alf239/speccy/docs/img/typed.png

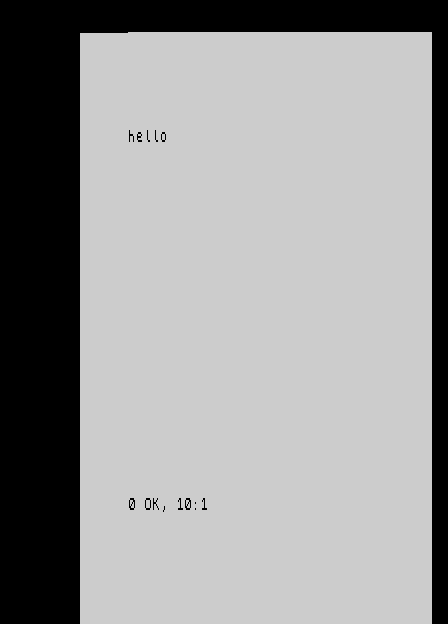
docs/img/typed.png
