alf239/speccy/(commit log)

2026-07-27 Stage 0: ZX Spectrum video generator + Verilator harness
    Raster timing (448x312 @ 7 MHz), screen address generation, attribute
    decode with BRIGHT/FLASH, and border colour from a register. Verified in
    simulation: 139776 pixels per frame, correct cell boundaries and colours.
    No CPU yet. Screen memory is loaded through the RAM's CPU-side port, which
    is deliberately the same port a Z80 will use later -- video time-multiplexes
    its own port for bitmap and attribute, so the two never collide.
    Also includes the design docs leading to the phase 1 target: a 48K machine
    with divMMC, fitting entirely in block RAM.
    [main.cpp, speccy_video_top.v, video.v, video_timing.v, vram.v]
2026-07-27 Add README
    Project overview, quick start, layout, and roadmap, with pointers into the
    design docs. Includes the stage 0 raster dump as evidence it works.
2026-07-27 Stage 1a: scandoubler, 15.625 -> 31.25 kHz
    Ping-pong line buffers reading each input line back at twice the rate.
    No rate matching needed: one input line is exactly 896 cycles of the 14 MHz
    clock, which is two output lines of 448.
    Pipeline is now indexed colour end to end (video -> scandoubler -> palette),
    so the line buffer carries 4 bits per pixel instead of 12, and there is one
    obvious place to hang a programmable palette later.
    The harness now checks rather than just draws: pixel counts on both rasters,
    output line pairs byte-identical, and the doubled line set matching the input
    line set. Exits non-zero on failure.
    Two bugs found and fixed by those checks:
    - vsync/vblank needed the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
    [main.cpp, palette.v, scandoubler.v, speccy_video_top.v, video.v, video_timing.v]
2026-07-27 Stage 1b/1c: board wrapper, Kempston joystick, memory image export
    The joystick needs no level shifting -- an Atari DE-9 stick is five passive
    switches to ground, so weak pull-ups on the FPGA pins are the whole interface.
    That makes it the one peripheral testable on hardware with no CPU.
    rtl/joystick.v synchroniser, debounce, Kempston 000FUDLR mapping
    rtl/de10_lite_top.v board wrapper: PLL, VGA, SW->border, joystick->LEDs/HEX
    sim/joystick_tb.cpp every direction and combination checked individually
    The bit mapping between a DE-9 connector and a Kempston port byte is exactly
    the thing that stays silently wrong until a game walks left when you push
    right, so it gets its own testben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
    [de10_lite_top.v, joystick.v, joystick_tb.cpp, main.cpp, speccy_video_top.v, vram.v]
2026-07-27 The machine around the CPU socket: memory map, ULA ports, INT
    Everything a Z80 plugs into, verified before choosing a CPU core. If the
    machine later misbehaves with a real Z80 in the socket, the fault is in the
    CPU rather than here.
    rtl/ram.v single-port RAM; a ROM is this with we tied low
    rtl/keyboard.v 48K matrix, 8 half-rows selected by A8..A15
    rtl/speccy.v memory map, port 0xFE, Kempston, 50 Hz interrupt, video
    sim/bus_tb.cpp the harness pretends to be the Z80
    Covered: ROM ignoring writes, banks not aliasing, any-even-port ULA decode,
    keyboard rows OR-ing when several are selected at once (which is how the ROM
    scans for any key), EAR on bit 6, Kempston bit mapping, a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
2026-07-27 Stage 3b: TV80 in the socket, executing code
    Vendored TV80 (github.com/hutch31/tv80 @ 66a131c, MIT, headers intact) with
    two local changes in tv80s.v, both marked and documented in rtl/tv80/README:
    1. cen exposed as a port -- tv80_core already implements the clock enable,
    the wrapper just tied it to 1. This runs the core at 3.5 MHz off the
    14 MHz machine clock.
    2. The wrapper's bus-signal block gated with the same cen. Ungated, it
    deasserted mreq_n/rd_n partway through a multi-clock T2, so every
    opcode fetch sampled the idle bus (0xFF = RST 38h) and the CPU
    livelocked pushing its own PC. The smoke test caught it on first run.
    speccy48.v is the complete machine.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
2026-07-27 Hardware pack: complete Quartus project, full-machine board top, boot test
    The Windows-box session is now: clone, convert ROM, open speccy.qpf, compile,
    program. No IP wizard, no pin import.
    quartus/speccy.qsf 121 pin assignments, cross-checked against three
    independent DE10-Lite projects (hildebrandmw/
    de10lite-hdl, MIPSfpga/schoolMIPS, yuri-panchul/
    basics-graphics-music) -- zero disagreements
    rtl/pll.v altpll instantiated by hand: 50 x 7/25 = 14 MHz
    rtl/de10_lite_speccy48.v the full machine on the board; boots rom48.hex
    to (c) 1982 with no keyboard attached
    tools/bin2hex.py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
2026-07-27 Fix make boot frame count; the machine boots the real 48K ROM
    make boot captured frame 7 instead of frame 174: the global FRAMES ?= 8
    default (meant for the video target) always satisfied boot's
    $(if $(FRAMES),...,175) fallback, so the "black screen" bug report was a
    photograph of the RAM test in progress -- border already white, attributes
    not yet written. The machine itself was booting correctly the whole time,
    confirmed by PC-histogram traces: RAM test done at ~25M cycles (1.8 s,
    matching real hardware), (c) 1982 rendered, then WAIT-KEY polling KEY-INPUT.
    Both targets now use $(or ...) locally and no global default exists.
    README now leads with the boot screenshot -- produced entirely b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
2026-07-27 Mark the hardware milestone: it boots on the real board
    (c) 1982 Sinclair Research Ltd on a VGA monitor, first-try bring-up.
    PLL parameters, all 121 pin assignments, and 50.08 Hz over VGA worked
    without modification.
2026-07-27 Bring-up postscript: hardware works; beeper output circuit
2026-07-27 Stage 3e: PS/2 keyboard, verified by typing into the real ROM
    rtl/ps2_rx.v: receive-only PS/2 receiver -- 11-bit frames, parity checked,
    watchdog resync. rtl/ps2_keyboard.v: scancode set 2 to the 40-key matrix,
    E0/F0 prefix tracking, chords for Backspace (CAPS+0), arrows (CAPS+5..8)
    and basic punctuation (SYM chords), E0 12 fake shifts ignored.
    18-case unit testbench (make ps2test), and the boot harness gained a
    typist: --type drives real scancode traffic into the PS/2 pins while the
    machine runs. Against the actual 48K ROM it has typed 10 P"hello" and R:
    program entered, executed, "hello" printed, 0 OK, 10:1. Screenshot in
    docs/img/typed.png.
    Two ROM behaviours the typist had to learn, bo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
2026-07-28 Phase 2 note: AY-vs-YM DAC curve on a switch, live-selectable
2026-07-28 Verified GPIO header pin table from the manual; wiring crib by physical pin
2026-07-28 Move every peripheral to the odd header column
    One physical row wires the whole machine: joystick on pins 1-3-5-7-9
    (GPIO[0,2,4,6,8]), keyboard 5V conveniently next at pin 11, PS/2 on 31/33
    (GPIO[26,28]), beeper on 39 (GPIO[34]). A single ground wire crosses to the
    even side. The Verilog cost is one commented concatenation; the breadboard
    gain is not having to count in two dimensions.
    Both board tops, qsf pull-ups, and the bring-up doc tables updated to match.
2026-07-28 Cobbler translation table; fix the ground row
    The GND label at the top of J2 is Pi pin 6 = DE10-Lite GPIO[5], a live
    FPGA I/O -- grounding peripherals there gives them no return path at all.
    Real grounds are J2 row 6 (labelled P18) and row 15 (labelled GND, truthful
    only by coincidence). Caught by Alexey cross-checking the Terasic manual.
2026-07-28 Pigtail ground wire is black, not blue (ambiguous 'B' in bench notes)
2026-07-28 PS/2 diagnostics on the 7-seg displays; debugging notes
    HEX3:2 = last scancode (a live keyboard shows AA from its power-on
    self-test before any key is pressed), HEX4 = raw clock-edge activity,
    HEX5 = frame-error count. Turns the board into its own protocol tester
    for the next keyboard: the stray NEXT keyword during contact-wiggling
    already proved receiver -> mapper -> matrix -> ROM works on real hardware.
    [de10_lite_speccy48.v]
2026-07-28 The Pi cobbler grounds six of our pins; move fire and beeper off them
    Kempston read 0x10 with no joystick attached: fire (GPIO[8], header pin 9)
    sits in a cobbler hole labelled GND, and the board pours all Pi-ground
    holes (Pi pins 6/9/14/20/25/30/34/39) into one net. DE10-Lite pin 30 is
    real ground, so the whole net is grounded -- five FPGA inputs and the
    beeper output included.
    Fire: GPIO[8] -> GPIO[10] (header pin 13, cobbler hole P27).
    Beeper: GPIO[34] -> GPIO[32] (header pin 37, cobbler hole P26).
    GPIO[8,11,17,22,29,34] documented as grounded-while-cobbler-fitted and
    kept tri-stated. Both board tops, qsf pull-ups and all doc tables updated.
    Diagnosis credit: the HEX Kempston readout ad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
2026-07-29 Stage 3g: .z80 snapshot loader -- boot straight into a game, no keys
    tools/snap2hex.py parses .z80 v1/v2/v3 (48K, compressed or not) and emits
    RAM bank init files plus a generated Z80 bootstrap: ~60 bytes restoring
    every register (alternates via below-stack push/pop, I, R, IM, border),
    ending in JP to the snapshot's PC.
    The machine gained a boot overlay: the stub shadows 0x0000-0x00FF from
    reset (armed by SW[1] on the board), and the first opcode fetch at or
    above 0x0100 -- the stub's own JP -- disarms it forever, restoring the
    real ROM under the running game.
    Verified end to end: a synthetic snapshot regression in make test (85
    checks now), and Saboteur II's actual .z80 boots to its title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
    [boot_tb.cpp, boot_tb_top.v, de10_lite_speccy48.v, speccy.v, speccy48.v, speccy48_tb_top.v]
2026-07-29 Tap-keys J and S on SW[6]/SW[7] (edge-triggered single press)
    key_tap.v: one synchronised rising edge of a slide switch = one ~80 ms
    keypress, then release regardless of switch position; flip down to re-arm.
    The right shape for menu letters, where a held slide switch would read as
    a stuck key. Switch already up at power-on does not fire.
    Full switch map documented: SW[0] free, SW[1] snapshot, SW[5:2] held
    ENTER/SPACE/1/2, SW[7:6] tap J/S, SW[8] reserved AY/YM, SW[9] sync.
    [de10_lite_speccy48.v, key_tap.v]
2026-07-29 Force M9K inference for ram.v -- fixes snapshot-stub synthesis failure
    Quartus implements the 256-byte stub as logic-cell registers (below its
    RAM-inference threshold), and register RAM cannot take an init file on
    MAX 10: error 276013 "MIF is not supported", then 276003 as the register
    fallback explodes. (* ramstyle = "M9K" *) pins every ram.v instance to
    block RAM, which is where they all belonged anyway. Verilator ignores
    the attribute; all 85 checks still green.
    [ram.v]
2026-07-29 Pin MAX 10 internal configuration to SINGLE IMAGE WITH ERAM
    Without memory-initialization in the internal flash configuration mode,
    MAX 10 block RAM cannot carry initial contents: every $readmemh memory
    (ROM, VRAM, upper RAM, snapshot stub) reports 276013 "MIF is not
    supported for the selected family" and synthesis fails at 276003. The
    qsf never pinned this, so it floated on whatever the local Quartus had
    -- the first successful build got a permissive mode by luck, the fresh
    checkout did not. Now explicit.
2026-07-29 Snapshot survives re-reset: shadow RAM + boot copier
    Block RAM init is configuration-time only, so the snapshot boot worked
    exactly once per programming: any later armed reset restored the
    snapshot's registers over whatever RAM held by then -- observed on
    hardware as the old BASIC screen frozen in the resumed PAUSE loop.
    The snapshot now lives twice: main banks (config init, as before) plus a
    never-written shadow pair. An armed reset holds the CPU (~7 ms) while a
    two-phase copier refills all 48K from the shadow, then releases into the
    stub. SW[1]+KEY[0] boots the game every time.
    New regression: boot normally for two frames (RAM scribbled), re-arm and
    reset mid-run, assert the snapshot sti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
    [boot_tb.cpp, speccy.v, speccy48.v]
2026-07-29 Piezo wiring option: direct drive through 47R, not the line divider
2026-07-30 boot_tb: --wav captures the beeper line to audio
    Samples the speaker at 43.75 kHz into 8-bit mono WAV. First use: extracting
    the menu music from the Saboteur II snapshot by running the machine and
    recording it, which beats static analysis of a self-modifying player whose
    tune pointer happened to be frozen at zero.
2026-08-01 Stage 5 design: divMMC + SD fit audit, pin plan, verification plan
2026-08-01 Stage 5 begins: SPI master + behavioural SDHC card, 22 checks green
    rtl/spi_master.v: mode 0, MSB-first, two speeds (350 kHz init / 7 MHz
    data), divMMC port semantics (write starts exchange, read returns rx).
    sim/sd_model.h: SDHC in SPI mode -- CMD0/8/55+ACMD41/58/16/17/24 against
    an in-memory disk image, bit-accurate mode-0 wire behaviour. Two model
    bugs found by the tests: output framing must lock to the byte boundary
    (one counter for both directions, like the real card), and pre-token
    write filler must be dropped per byte, not batch-discarded.
    make sdtest covers loopback, clock division, the full esxDOS-style init
    conversation, block read verification, and a write/readback roundtrip.
    Su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
    [sd_model.h, sd_tb.cpp, spi_master.v]
2026-08-01 Stage 5 step 3: divMMC in the machine -- automapper, MAPRAM, SPI ports
    The automapper implements divIDE/divMMC's designed delay: the trapped M1
    fetch (0x0000/0x0008/0x0038/0x0066/0x04C6/0x0562/0x3Dxx) still executes
    from Spectrum ROM, and the mapping flips at the cycle's end; exit fetches
    at 0x1FF8-0x1FFF unmap the same way, so the RET there runs from esxDOS
    ROM and lands back in BASIC. Port 0xE3 carries CONMEM, the sticky
    MAPRAM bit (bank 3 becomes a write-protected ROM; only reset clears),
    and the bank select for the 0x2000 window.
    The SPI data port (0xEB) holds the Z80's WAIT line while an exchange is
    in flight -- the first use of wait_n in the machine -- so the mandatory
    <=400 kHz init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
    [boot_tb_top.v, bus_tb.cpp, de10_lite_speccy48.v, speccy.v, speccy48.v, speccy48_tb_top.v]
2026-08-02 Stage 5 step 4: esxDOS 0.8.9 boots in simulation, browser and all
    The full stack works end to end in Verilator: reset trap -> esxDOS init
    -> WAIT-stretched SPI at the spec's slow init clock -> SDHC init
    conversation -> CSD/CID -> MBR -> FAT16 mount of a generated image ->
    SYS modules loaded [OK] -> BASIC with hooks -> NMI file browser listing
    the card's directory tree.
    Four integration bugs, all invisible to the 24 unit checks:
    - esxDOS requires >=5 divRAM banks: divRAM widened to 64K/8 banks and
    UNIFIED with the snapshot shadow (one array, two masters; saves 32K
    of M9K net, documented mixed-use trade-off)
    - port 0xEB reads return the latched byte and clock a new 0xFF
    exchan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
    [boot_tb.cpp, boot_tb_top.v, bus_tb.cpp, de10_lite_speccy48.v, sd_model.h, sd_tb.cpp]
2026-08-02 DIN-5 AT socket wiring (front/solder view warning included)
2026-08-02 Video timings fix attempt
    [video_timing.v]
2026-08-02 SD diagnostics on HEX3:0 in divMMC mode + weak pull-up on MISO
    Hardware hangs at esxDOS 'Detecting Devices...' -- the SPI conversation
    with the real card is failing and the board had no way to show where.
    In divMMC mode (SW[0]) the displays now show:
    HEX1:0 last SPI byte the CPU read from the card
    FF forever = card never answers (wiring/contact)
    01 = alive but stuck in idle (init loop)
    HEX3:2 exchange counter, spins while esxDOS talks
    HEX5:4 stay on PS/2 diagnostics. Plain mode is unchanged.
    Also: weak pull-up on GPIO[18] (MISO) in the qsf, belt-and-braces.
    [boot_tb_top.v, de10_lite_speccy48.v, speccy.v, speccy48.v, speccy48_tb_top.v]
2026-08-02 Revert the sync offset
    [video_timing.v]
2026-08-02 divRAM wipe on divMMC reset: SW[0] boots always cold-boot esxDOS
    Second divMMC boot after a soft reset skipped the banner and device
    detection, landing silently in BASIC -- esxDOS's warm-boot marker lives
    in divRAM, which survives KEY[0] in block RAM. With a card that failed
    detection this meant no retry without reprogramming the FPGA.
    Reproduced in simulation with a new boot_tb --reset-at N flag (also
    reachable as make esx RESET=n). Fix: a reset that enters divMMC mode
    zeroes all 64K of divRAM before releasing the CPU (~4.7 ms inside the
    reset), so every SW[0] boot is a genuine cold boot. Snapshot-armed
    resets never wipe -- the shadow must survive for replay.
    The SD model also now aborts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
    [boot_tb.cpp, sd_model.h, speccy.v]
2026-08-03 SD diagnostic HEX1:0 latches last non-FF byte from the card
    During retry loops the last-byte view is flooded with 0xFF response
    hunts, hiding any single answer the card might have given. Sticky
    non-FF latch instead: FF on the display now means the card has never
    driven MISO low at all since reset.
    [de10_lite_speccy48.v, speccy.v]
2026-08-03 Stage 5 complete on hardware: games load from SD via esxDOS
    First game from the card: Exolon. The detection failure was the SD
    breakout's friction-fit header resting unsoldered in the prototype
    board -- all six wires in the right holes, no connection. Found by
    wiggling while watching the new HEX diagnostics; fixed with solder.
2026-08-04 Evaluate a ZX-48 form-factor carrier board for the DE10-Lite
    The machine moves into a modern ZX case with a Cherry MX keyboard:
    a carrier PCB in the original board outline hosts the DE10-Lite as a
    daughterboard, absorbs the cobbler/prototype stack, and scans the
    case's keyboard -- which is electrically the original 8x5 matrix on
    the original tail sockets -- with 13 GPIOs and ~50 lines of Verilog.
    Verdict: feasible and cheap; the routing is trivial, the mechanical
    fit is the real work. Custom FPGA board deferred to phase 3.
2026-08-04 Carrier doc: Sinclair joystick is passive matrix taps, zero GPIOs
    Interface 2 style -- five switches bridging the keyboard matrix
    traces for keys 6-7-8-9-0. Costs traces, not pins. Fit it.
2026-08-04 Promote the from-scratch MAX 10 board from phase 3 to the plan
    Two facts move it within reach: DE10-Lite GPIO is wired straight to
    the FPGA (the RTL ports with just a .qsf pin table), and 10M50SAE144
    exists -- same 50K LE and M9K in a single-supply EQFP-144 that any
    PCBA service handles. SDRAM lands on copper now, ready for phase 2.
2026-08-06 Phase 2 opens: AY-3-8912 from scratch, singing in simulation
    The Scorpion story starts with its voice: an AY needs no 128K (the
    Melodik proved it), and the card already carries .playpt3 and the
    browser's PT3 plugins. rtl/ay8912.v implements the datasheet -- tones,
    noise LFSR, envelopes, register masks, R14 readback -- at 1.75 MHz.
    SW[8] picks AY (16-step) or YM (32-step) envelope resolution. Beeper
    and AY mix into a 10-bit bus and leave through a sigma-delta DAC on
    the same GPIO pin as before: three new voices, zero new wires.
    Verified at three levels: 21 unit checks incl. a sparse-ce regression,
    bustest driving the real port decode, and the smoke ROM programming
    the chip via OUT (C),A with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
    [ay8912.v, ay_tb.cpp, boot_tb.cpp, boot_tb_top.v, bus_tb.cpp, cpu_tb.cpp, de10_lite_speccy48.v, make_cpu_rom.py]
2026-08-07 The 128K machine: #7FFD paging, twin ROMs, banks in SDRAM
    128 mode is a runtime input sampled at reset (SW[2] up forces 48K;
    snapshot arm implies 48K), so the identical build serves both machines
    and every existing 48K test runs unchanged. #7FFD: bank at 0xC000,
    screen select, ROM select, lock bit latched till reset -- Pentagon
    partial decode, the famous port-0xFD quirk included.
    Memory per the stage-2 plan: screen banks 5 and 7 in dual-port M9K
    (video never touches SDRAM, bank 5 aliases 0x4000/0xC000), banks
    0-4 and 6 in the SDRAM with WAIT stretching the CPU on the alignments
    where 7 controller cycles poke out of the Z80 window. ROM0 is the 128
    editor (ROM128_FILE / quartus rom128.hex, gi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
    [boot_tb.cpp, boot_tb_top.v, bus_tb.cpp, de10_lite_speccy48.v, speccy.v, speccy48.v, speccy48_tb_top.v]
2026-08-08 128K: init-stall fix, exec-from-SDRAM coverage, PoP loads to title
    The SDRAM glue dropped requests issued during the controller's 2 ms
    init ritual -- exactly where the 128 ROM's RAM test lands. A silently
    lost write read as 'RAM broken' and ROM0 bailed to 48 BASIC. Requests
    now wait on ready, WAIT holds the CPU, and bustest's 128K section
    deliberately fires its first accesses into the init window.
    The smoke ROM grows two probes: the #7FFD paging sequence the 128 ROM
    uses (both modes checked), and a copy-CALL-RET through RAM that in
    128K mode exercises M1 opcode fetches from SDRAM -- the one bus
    pattern nothing else covered. The ISR counter moves to SDRAM in 128K
    mode, adding a 50 Hz read-mo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
    [bus_tb.cpp, cpu_tb.cpp, make_cpu_rom.py, speccy.v, speccy48_tb_top.v]
2026-08-08 128-menu bug solved: ROM0 requires its matched ROM1 (128-1.rom)
    The full-bus trace caught the third inter-ROM call planting 0x3C04 as
    the SWAP return address -- a routine that exists only in the 128's own
    patched ROM1 (1,177 bytes differ from the standalone 48 ROM; a whole
    editor-support block lives at 0x386E-0x3CFF, which in 48.rom is font
    filler -- hence the slide through the character set and screen into a
    48 cold boot).
    Fix is usage, not RTL: 128-capable builds use 128-1.rom as ROM_FILE
    everywhere. Verified esxDOS-safe (LD-BYTES, SA-BYTES and every divMMC
    trap point byte-identical) and a correct 48 BASIC for 48 mode and
    snapshots. With the matched pair the 128 menu appears -- (c) 1986,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
    [boot_tb.cpp]
2026-08-08 AY register logger + transcription tool; test-footgun killed for good
    boot_tb --aylog snoops every OUT to the AY ports (frame, register,
    value); tools/ay2notes.py replays the log into per-channel note events
    -- exact tone periods at the 1.75 MHz clock, envelope/noise flags --
    and writes a 3-track MIDI. First customer: the Prince of Persia 128K
    title theme (G minor, 125 BPM, kick-sweep bass pedal on channel B,
    melody + ornament glissandi on A), transcribed for bass and guitar.
    boottest/snaptest now save and restore the baked hex files they borrow
    -- the clobber footgun fired a third time, disguising smoke-ROM runs
    as game crashes (the giveaway: a 'stuck tone' at exactly 2187.5 Hz,
    the smoke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
    [boot_tb.cpp, bus_tb.cpp]
2026-08-08 Board: mode switches sampled at reset only
    Flipping SW[1] (or SW[0]/SW[2]) mid-session yanked the divMMC ROM out
    from under a hooked, running machine -- the next interrupt executed
    garbage and the machine crash-restarted, observed on hardware as 'SW1
    resets the speccy'. divmode/arm/en_128 now latch at KEY[0] reset like
    mode128 always did: flip switches, then reset, like a real rear panel.
    [de10_lite_speccy48.v]
2026-08-08 Prince of Persia runs on hardware: the 128K stage is complete
    esxDOS boot on the 128K machine, PoP loaded from the SD card, playing
    on the real board. The acceptance test passed on silicon.
2026-08-09 ay2notes: envelope (buzz) bass, honest tempo grid
    The AY's third con, found by ear before it was found in the registers:
    the pumping bass is the envelope generator used as an oscillator --
    pitch in R11/R12, retrigger via R13, sounding regardless of the mixer.
    The tool now pitches env-mode channels from the envelope period
    (biased sharp-ward: integer periods run ~50 cents flat of the tone
    scale), splits notes on R13 retriggers so the pump articulation
    survives, and drops ultrasonic envelope clicks. MIDI export retimed
    to division 24 / 480 ms so DAW bars are the musical 125 BPM bars.
2026-09-11 PCB sketch v0: floorplan on the Issue Two's geography
    The real Issue Two in the repro case is the mechanical datum. Every
    original aperture is reused: EAR/MIC holes become line-out + EAR-in,
    the expansion slot becomes the rear connector strip (VGA, 2x DE-9,
    microSD, JTAG), the 9V barrel hole takes a wide-input buck so the
    original Sinclair PSU is safe to plug in, and the modulator bay goes
    to the quiet analog. 10M50SAE144 + SDRAM + oscillator sit in the old
    ULA/CPU/RAM acreage; keyboard tails use the original sockets at the
    original front-edge positions. Next: caliper session for the outline
    DXF, then KiCad.
2026-09-11 PCB sketch v0.1: rear panel is re-printable, keyboard tails are law
    The case's rear panel is a modular re-printable piece, so rear
    connector positions become routing-driven and the panel follows the
    board. The constraint hierarchy inverts: the two keyboard tail
    sockets (original connectors, in hand) are now the only externally
    dictated XY on the board, promoted to fixed-position styling in the
    floorplan, alongside the mounting bosses. Added a rear-panel
    elevation sketch (viewed from behind): JTAG, microSD, VGA, two DE-9s,
    reset pinhole, audio jacks near the original M/E holes, and the NMI
    button in the old TV-out hole -- games now enter where the picture
    used to leave.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
2026-09-11 Floorplan: keyboard tails staggered per Issue 2 geometry
    The two membrane sockets are not side-by-side on the front edge: the
    8-way sits at the front edge and the 5-way sits inboard behind it,
    front-left region -- which is also why the membrane's two tails have
    different lengths. Caught by the user against the Issue Two on the
    desk; rectangles remain indicative until the caliper session.
2026-09-11 Floorplan v0.3: measured outline and keyboard slot positions
    Real calipers, real numbers: the board is 211.5 x 130 mm (not the
    folkloric 233 x 144), and the two membrane slots live mid-board near
    the RIGHT edge -- 27 and 30 mm from it, 64 and 57 mm up from the
    front -- stacked with a small offset, nowhere near my front-left
    guess. Everything re-placed around them: FPGA/SDRAM shift left of the
    slots, DIP/buttons move toward the power corner, keep-out halo where
    the tails drop in. Still to measure: boss centers/count, slot extents
    and which slot is 5- vs 8-way.
2026-09-11 Floorplan v0.4: slots flank the board; corridor hosts the core
    Corrected measurement semantics: each slot measured from its OWN
    nearest edge to its nearest contact. KB1 (5-way, lower) leftmost
    contact 30mm from the LEFT edge, 57mm from the bottom; KB2 (8-way)
    rightmost contact 27mm from the RIGHT edge, 64mm up. The slots flank
    the board with a free mid-height corridor between their inner ends --
    FPGA, SDRAM and oscillator move in there. Slot lengths drawn at an
    assumed 6.35mm tail pitch, to confirm against the real sockets.
2026-09-11 PCB sketch: record the measured law + keyboard-photo confirmation
    Board 211.5 x 130; KB1 5-way leftmost contact 30mm from left / 57mm
    from bottom; KB2 8-way rightmost contact 27mm from right / 64mm from
    bottom. The case keyboard's underside photo confirms the mirror
    mapping and the ~8cm dictated tails.
2026-09-11 Floorplan v0.5: the two real mounting holes, measured
    The invented bottom-centre boss is gone. Reality: a 2mm board-mount
    hole at centre, 40mm from the bottom edge, and a 3mm pass-through for
    the case bolt at 5mm from the top edge (X assumed centred, to
    confirm). The four corner holes I drew remain dashed question marks
    until confirmed to exist at all.
2026-09-11 Sketch: measured keyboard socket pitch and contact faces
    Macro photos against a steel ruler: contact pitch ~2.5mm (4 joints
    per cm) -- the 6.35mm assumption was off by 2.5x, so the slots shrink
    to ~16mm and ~23mm bodies at the measured anchor points. Contact
    faces oppose: 5-way on top, 8-way on bottom -- the two tails insert
    printed-face opposite ways, now recorded per slot. Tiebreak between
    2.54 and 2.50mm pitch: caliper the first-to-last contact spans.
2026-09-11 Floorplan v0.7: top corner holes inset per white-background photos
    The topmost left/right holes are not at the corners: the left one
    sits ~12mm in beside the modulator shield, the right one ~14mm in
    between the edge-connector end and the power jack (photo-derived,
    to freeze with ruler readings). Bottom corners remain dashed
    questions.
2026-09-11 Floorplan v0.8: the true fixing scheme, measured
    The case actually holds the board by a symmetric pair of 4mm holes at
    mid-sides -- 5mm in from each side edge, 44.5mm from the top edge --
    plus the 2mm centre mount and the 3mm top bolt pass-through. The
    top-corner holes exist on the Issue Two but are unused by this case;
    kept as optional legacy holes. No bottom fixings.
2026-09-11 Floorplan v0.9: hole census complete
    Bottom corners exist after all: 4mm each, 4.5-5mm from both closest
    edges. Seven real holes (2x4mm mid-sides used, 2x4mm bottom corners,
    2mm centre mount, 3mm top bolt pass) plus two unused legacy top
    corners.
2026-09-11 pcb/: 1:1 printable drill-and-slot template
    First inhabitant of the pcb directory: a millimetre-true SVG of the
    measured board -- outline, all seven real holes with crosshairs, two
    legacy holes dashed, and the keyboard contact rows ticked at 2.54mm
    pitch so laying the real socket on the printout doubles as the
    2.54-vs-2.50 tiebreak. Print at 100% and verify the 50mm bar first.
2026-09-11 Speaker sound hole added to floorplan and 1:1 template
    The Issue Two has a through-hole under the speaker at the board's
    front-right, venting the beeper toward the case-bottom slots -- the
    repro case has the same vents, so the hole (and a small onboard
    speaker + driver next to it) joins the design. Position photo-
    estimated at ~(190, 18.5 from bottom), ~10mm dia; exact centre and
    diameter to be read off the ruler before the template is trusted.
2026-09-11 Board width corrected to 213.5mm; drawings now generated from one table
    Third geometry revision earned proper tooling: tools/gen_pcb_sketch.py
    holds the measurement table (outline, holes, slots, speaker, pitch)
    and regenerates both the floorplan and the 1:1 template. All right-
    edge-referenced features shifted +2mm with the corrected width; the
    centre-assumed pair moved to 106.75. Future corrections are one-line
    edits.
2026-09-11 Paper drop-test catch: oscillator off the centre mount screw
    The 50MHz block sat on the 2mm centre fixing; moved beside the FPGA's
    left flank. Same audit found the rear connector strip running over
    the top bolt-pass at W/2 -- the strip now parts around it (VGA +
    microSD left of the bolt, DE-9s + JTAG right).
2026-09-11 Speaker hole 6mm down per print test; speaker note
    Print-in-case check: hole centre now 12.5 fr bottom (x still
    photo-estimated at 21.5 fr right). Original Issue 1/2 speaker is a
    weird 200-ohm unit (Issue 3+ went 40-ohm) because the ULA drove it
    near-directly; our board has a proper amp, so a standard 40mm 8-ohm
    mylar speaker matches physically without chasing rare impedances.
2026-09-11 KB1 slot 1mm lower (56 fr bottom) after print check
    Floorplan slot labels now derive from the KB dicts instead of
    hardcoding the numbers, so the table stays the single source.
2026-09-12 Pitch tiebreak measured: 2.50 mm metric
    5-way first-to-last span calipers at 10.0 mm (2.54 pitch would give
    10.16). Slots are true metric 2.50 -- footprint must not be a 0.1-inch
    header. Template tick note updated; docs to-measure list trimmed.
2026-09-12 Doc: speaker decision -- 40mm 8-ohm + class-D, not the period impedances
    Issue 1/2 used ~200-ohm, Issue 3+ 40-ohm, both artefacts of the
    ULA-era drive circuit; with a PAM8302-class amp on the board a
    standard 8-ohm part is correct.
